Shadowpasha/Flight_Controller_Oqab/docs/oqab_control_estimation_architecture.pdf

## Oqab ESP32 Flight Controller

State Estimation, Multi-Rate Sensor Fusion, and Cascaded Control Architecture

Generated from balance_controller Firmware

November 2026

Abstract

This document describes the complete state estimation and flight control architecture implemented in the Oqab ESP32 quadrotor firmware (balance_controller). It details the dual-core FreeRTOS task split, sensor hardware and coordinate conventions, complementary and Kalman state estimators, optical flow derotation and latency compensation pipeline, autonomous flight mission state machine, PX4-style cascaded position and altitude outer loops, nine selectable inner attitude controllers, and the Quad-X motor mixer. TikZ flowcharts illustrate task execution, sensor fusion dataflows, state transitions, and cascaded feedback loops.

## Contents

1 System Overview and Dual-Core Execution | 2
2 Hardware Sensors and Coordinate Conventions | 2
3 State Estimation Architecture | 3
4 Autonomous Flight Mission State Machine and Safety Guards | 6
5 Cascaded Control Architecture | 6
6 Inner Attitude Controllers (250 Hz) and Flight Modes | 7
7 Quad-X Motor Mixing and Saturation | 9

## 1 System Overview and Dual-Core Execution

The Oqab flight controller runs on an ESP32 dual-core microcontroller using FreeRTOS to isolate deterministic real-time control from asynchronous UART parsing, telemetry serialization, and Flash NVS parameter storage.

- Core 1 (loop(), Priority 15): Executes the deterministic flight control pipeline at 250 Hz (∆t = 4000 µs), with nested time-triggered sub-loops at 50 Hz (20 ms) for vertical/horizontal estimation and outer control loops, and 10 Hz (100 ms) for optional GPS updates.
- Core 0 (CommsTask, Priority 2, 8 KB stack): Runs at 100 Hz (10 ms period via vTaskDelayUntil) on the same core as Bluetooth SPP. It drains Serial2 (MSPv2 optical flow and LiDAR, or NMEA GPS), processes CLI commands over USB Serial (115200 baud) and Bluetooth (Oqab_Flight_Controller), saves tuned parameters to ESP32 NVS Flash (drone_params), and emits telemetry at 20 Hz when disarmed or 50 Hz in simulation mode (muted when armed to prevent serial blocking).

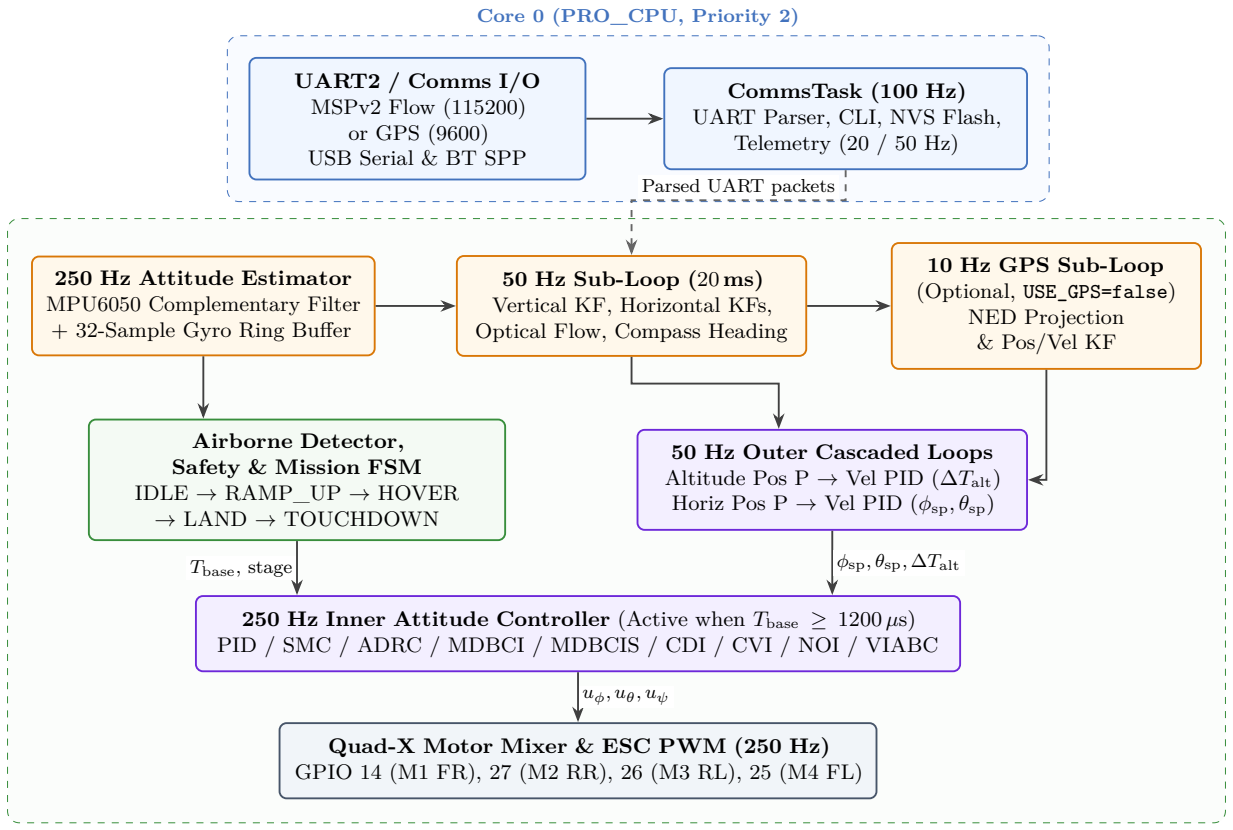
[picture p1: figure]
Core 0 (PRO_CPU, Priority 2); UART2 / Comms I/O MSPv2 Flow (115200) or GPS (9600) USB Serial & BT SPP; CommsTask (100 Hz) UART Parser, CLI, NVS Flash, Telemetry (20 / 50 Hz); 250 Hz Attitude Estimator MPU6050 Complementary Filter + 32-Sample Gyro Ring Buffer; 50 Hz Sub-Loop (20 ms) Vertical KF, Horizontal KFs, Optical Flow, Compass Heading; 10 Hz GPS Sub-Loop (Optional, USE_GPS=false) NED Projection & Pos/Vel KF; Airborne Detector, Safety & Mission FSM IDLE → RAMP_UP → HOVER → LAND → TOUCHDOWN; 50 Hz Outer Cascaded Loops Altitude Pos P → Vel PID (∆Talt) Horiz Pos P → Vel PID (ϕsp, θsp)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

Core 1 (APP_CPU, Priority 15, Deterministic 250 Hz)

250 Hz Inner Attitude Controller (Active when Tbase ≥ 1200 µs) PID / SMC / ADRC / MDBCI / MDBCIS / CDI / CVI / NOI / VIABC

GPIO 14 (M1 FR), 27 (M2 RR), 26 (M3 RL), 25 (M4 FL)

Figure 1: Dual-core FreeRTOS scheduling and multi-rate execution flow across Core 0 and Core 1.

## 2 Hardware Sensors and Coordinate Conventions

### 2.1 Sensor Suite and Interfaces

All sensors sit behind abstract C++ interfaces defined in Sensors.h: IMUInterface, RangefinderInterface, BarometerInterface, CompassInterface, OpticalFlowInterface, and GPSInterface. Table 1 summarizes the hardware drivers and buses.

Subsystem | Hardware / Driver | Bus / Rate | Role in Firmware
IMU | MPU6050 (0x68) | I2C 400 kHz, 250 Hz read | 3-axis | accel | (±8g),
gyro (±500◦/s), 44 Hz
| | | DLPF
Optical Flow & ToF | Mateksys 3901-L0X | UART2 (RX 16, TX 17),
| | 115200 baud

MSPv2 0x1F02 flow,
0x1F01 VL53 ToF Li-DAR (0.03–2.00 m)
Compass | GY-87 (QMC5883P / HMC5883L) | I2C bypass, 50 Hz read | Tilt-compensated True
North yaw reference
GPS (Legacy) | NEO-M8N (NMEA) | UART2 shared,
| | 9600 baud, 10 Hz

Disabled by default
(USE_GPS = false)
Baro / Sharp IR | BMP180 / GP2Y0A | Dewired / Inactive | Bypassed when ToF Li-
DAR mode is enabled
(USE_LIDAR_ONLY_ALTITUDE)

Table 1: Active sensor hardware and bus configuration defined in Config.h and Sensors.cpp.

### 2.2 Body Frame Sign Conventions and Lever Arms

The firmware uses a body-fixed frame where +X points Forward, +Y points Right, and +Z points Down for physical lever-arm offsets relative to the center of mass (CM):

rflow =

−0.04
+0.01
+0.03

m, rimu =

−0.02
+0.02
0.00

m. (1)

From StateEstimator.cpp, gyroscope rates after calibration bias subtraction and axis sign mapping satisfy:

gx = −(gx,raw − bgx)

180
π
(right wing down > 0), | (2)

gy = (gy,raw − bgy)

180
π
(nose down > 0), | (3)

gz = (gz,raw − bgz)

180
π
(clockwise yaw > 0). | (4)

Correspondingly, positive roll ϕ > 0 tilts the right wing down, positive pitch θ > 0 pitches the nose down (accelerating forward), and positive yaw ψ > 0 rotates clockwise when viewed from above.

## 3 State Estimation Architecture

State estimation is partitioned into three estimators: a 250 Hz attitude complementary filter, a 50 Hz 3-state vertical Kalman filter, and two decoupled 50 Hz 3-state horizontal Kalman filters fused with latency-compensated optical flow (and optional 10 Hz GPS). Figure 2 summarizes the full estimation pipeline.

### 3.1 Attitude Complementary Filter (250 Hz)

At each 4 ms step, calibrated accelerometer angles are computed as:

ϕacc = atan2
ay,

q
a

2
x + a

2
z

180
π

, θacc = atan2
ax,

q
a

2
y + a

2
z

180
π
. | (5)

Roll and pitch fuse gyro integration with accelerometer tilt (αatt = 0.991):

ϕk = αatt (ϕk−1 + gx∆t) + (1 − αatt) (ϕacc − ϕcal), | (6)
θk = αatt (θk−1 + gy∆t) + (1 − αatt) (θacc − θcal). | (7)

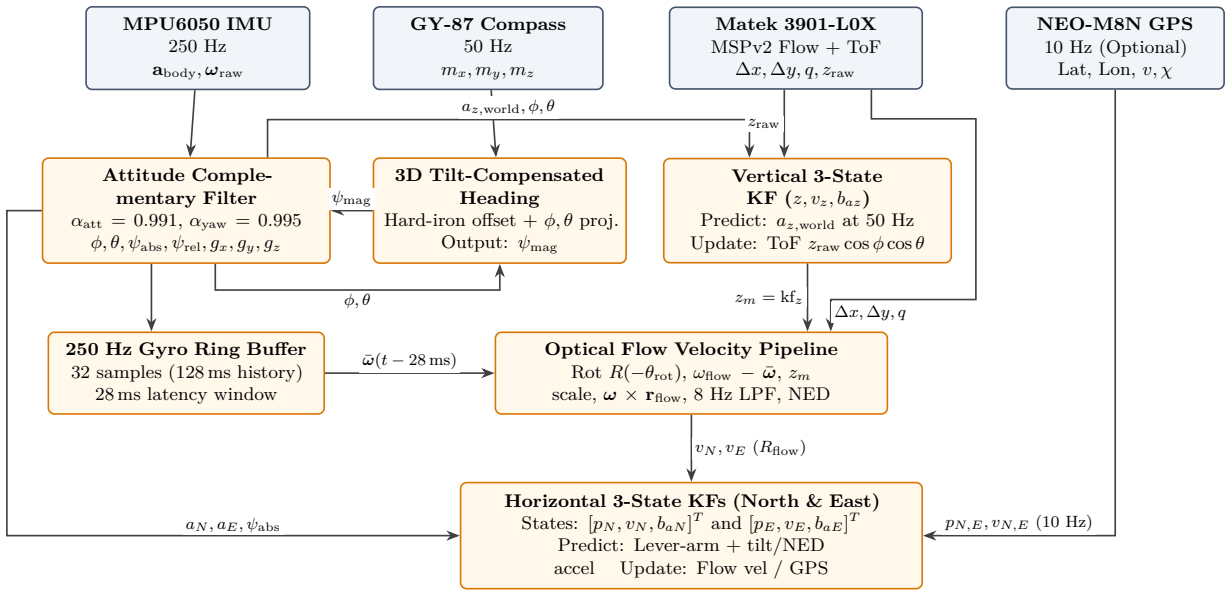
[picture p2: figure]
MPU6050 IMU 250 Hz; abody, ωraw; GY-87 Compass 50 Hz mx, my, mz; Matek 3901-L0X MSPv2 Flow + ToF ∆x, ∆y, q, zraw; NEO-M8N GPS 10 Hz (Optional) Lat, Lon, v, χ; Attitude Comple- mentary Filter αatt = 0.991, αyaw = 0.995 ϕ, θ, ψabs, ψrel, gx, gy, gz; 3D Tilt-Compensated Heading Hard-iron offset + ϕ, θ proj. Output: ψmag; Vertical 3-State KF (z, vz, baz) Predict: az,world at 50 Hz Update: ToF zraw cos ϕ cos θ; 250 Hz Gyro Ring Buffer 32 samples (128 ms history) 28 ms latency window; Optical Flow Velocity Pipeline Rot R(−θrot), ωflow − ω¯, zm scale, ω × rflow, 8 Hz LPF, NED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

Figure 2: Multi-rate sensor fusion and state estimation dataflow across attitude, vertical, and horizontal estimators.

Compass readings (updated at 50 Hz) subtract hard-iron biases (mx0, my0, mz0) and project onto the horizontal plane using (ϕ + ϕcal, θ + θcal):

Xh = mx cos θ + my sin ϕ sin θ + mz cos ϕ sin θ, | Yh = my cos ϕ − mz sin ϕ, | (8)

ψmag = atan2(Yh, Xh)

180
π
+ δmag. | | (9)

Absolute heading fuses gyro gz with ψmag (αyaw = 0.995), wrapped to [−180◦

| , 180◦
]:
ψabs,k = ψabs,k−1 +gz∆t+ (1−αyaw) wrap180(ψmag −ψabs,k−1), | ψrel = wrap180(ψabs −ψoffset). (10)

Crucially, NED world-frame projections for horizontal estimation and position control use ψabs, whereas yaw damping uses body rate gz.

3.2 3-State Vertical Kalman Filter (50 Hz)

The vertical estimator tracks xz = [z, vz, baz]

T
(altitude in m, climb rate in m/s, and vertical accelerometer bias in m/s²
). World vertical acceleration removes gravity along the tilted body axes:
az,world = ax sin θ − ay sin ϕ cos θ + az cos ϕ cos θ − 9.80665. | (11)

When airborne (or in simulation mode), the prediction step propagates with acorr = az,world − baz and state transition matrix Fz:

xz,k|k−1 =

1 ∆t −

1
2∆t

2
0 | 1 | −∆t
0 | 0 | 1

xz,k−1 +

1
2∆t

2
∆t
0

az,world, Qz = diag(0.0002, 0.0035, 0.00003). (12)

Prior to airborne liftoff confirmation, z tracks the ground baseline or valid ToF reading directly with vz = baz = 0 and primed covariance Pz = diag(0.01, 0.05, 0.01). The Mateksys VL53 ToF LiDAR measurement is tilt-compensated:
zrf = zraw cos ϕ cos θ, | (13)

and accepted when LiDAR quality > 30, |ϕ|, |θ| ≤ 35◦
, and 0.03 ≤ zrf ≤ 2.00 m. Scalar Kalman updates use measurement matrix H = [1 0 0] and variance Rlidar = 0.0025 m²

, clamping |baz| ≤ 2.0 m/s² .

### 3.3 Horizontal 3-State Kalman Filters and Optical Flow Pipeline (50 Hz)

Two identical 1D 3-state Kalman filters (kfNorth, kfEast) estimate xh = [p, v, ba]

T along Earth North
and East using Qh = diag(0.005, 0.035, 0.0005).

Inertial Prediction Step

First, IMU centrifugal acceleration from yaw rate gz (in rad/s) due to CM offset (rimu,x, rimu,y) is compensated, gravity projections are canceled, and calibrated static offsets are subtracted:

ax,cm = ax + g

2
z
rimu,x, | ay,cm = ay + g
| 2 z
| rimu,y, | (14)
afwd = ax,cm cos θ − az sin θ − afwd,0, | aright = ay,cm cos ϕ − az sin ϕ − aright,0. | (15)

Rotating into Earth NED via ψabs gives aN = afwd cos ψabs − aright sin ψabs and aE = afwd sin ψabs + aright cos ψabs. Inside predict(), bias-corrected acceleration acorr = ameas − ba applies a noise-floor deadband (|acorr| < 0.015 m/s² ⇒ 0) and velocity clamp |v| ≤ 6.0 m/s. While resting on the ground, states are held at zero to prevent stationary drift.

Optical Flow Velocity Measurement Update

When a new MSPv2 0x1F02 packet arrives with surface tracking quality q ≥ 35, the optical flow estimator (updateOpticalFlowEstimator()) executes six stages:

1. Latency-Matched Gyro Window: Extracts delayed gyro averages (g¯x, g¯y, g¯z) from the 250 Hz 32-sample ring buffer shifted back by round(FLOW_DELAY_MS/4 ms) = 7 samples (28 ms) across the flow integration window (≈ 5 samples for 20 ms).
2. Mounting Rotation & Scaling: Rotates raw counts (sx, sy) by −θrot (default 90◦
) into body
Forward/Right counts and scales by srad = 0.00380 rad/count:

ωflow,x =

sx cos θrot − sy sin θrot
∆t
srad, | ωflow,y =

sx sin θrot + sy cos θrot
∆t
srad. | (16)
3. Gyro Derotation & Height Scaling: Subtracts body angular rates (matching sign conventions: nose-down g¯y and forward translation sweep ground features identically) and scales by clamped vertical KF height zm ∈ [0.05, 3.00] m:
vsens,fwd = (ωflow,x − g¯y)zm, | vsens,right = (ωflow,y − g¯x)zm. | (17)
4. Rigid-Body Lever-Arm Compensation: Removes tangential velocity ω × rflow caused by rotation about the CM (with nose-up rate qup = −g¯y):
vraw,fwd = vsens,fwd − (quprz − g¯zry), | vraw,right = vsens,right − (¯gzrx − g¯xrz), | (18)

clamped to ±3.5 m/s.

5. Low-Pass Filter & NED Rotation: Filters body velocities with a 1st-order exponential LPF (α = 1 − e

−2πfc∆t
, fc = 8.0 Hz) and rotates by ψabs to (vN , vE).
6. Quality-Adaptive Kalman Update: Updates kfNorth.updateVel and kfEast.updateVel when airborne or in sim mode using quality-scaled variance:

Rflow = clamp

2Rflow,0
q/255

, 0.015, 0.40
, Rflow,0 = 0.02 m²
/s
| 2
| . | (19)

When GPS is enabled (updatePositionEstimator() at 10 Hz with ≥ 5 satellites and HDOP ≤ 4.0), flat-Earth lat/lon offsets update position with Rpos = clamp(0.4 HDOP²
, 0.4, 15.0) and Doppler velocity updates velocity with Rvel = 0.08.

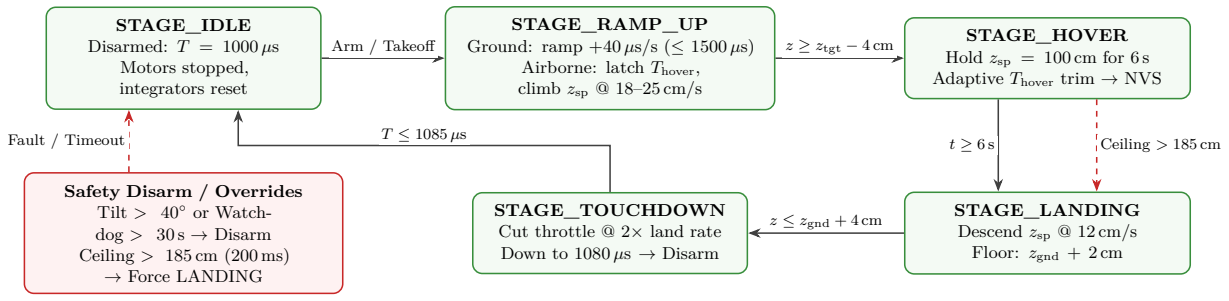
[picture p3: figure]
STAGE_IDLE Disarmed: T = 1000 µs Motors stopped, integrators reset; STAGE_RAMP_UP Ground: ramp +40 µs/s (≤ 1500 µs) Airborne: latch Thover, climb zsp @ 18–25 cm/s; STAGE_HOVER Hold zsp = 100 cm for 6 s Adaptive Thover trim → NVS; Safety Disarm / Overrides Tilt > 40◦ or Watch-; dog > 30 s → Disarm Ceiling > 185 cm (200 ms) → Force LANDING; STAGE_TOUCHDOWN Cut throttle @ 2× land rate Down to 1080 µs → Disarm; STAGE_LANDING Descend zsp @ 12 cm/s Floor: zgnd + 2 cm; Arm / Takeoff; z ≥ ztgt − 4 cm; z ≤ zgnd + 4 cm

T ≤ 1085 µs Fault / Timeout | Ceiling > 185 cm

Figure 3: Autonomous flight mission state machine, airborne liftoff handoff, and safety overrides.

## 4 Autonomous Flight Mission State Machine and Safety Guards

Before the inner attitude loop computes motor commands, Core 1 evaluates airborne detection, safety overrides, and the 5-stage autonomous mission state machine (balance_controller.ino).
Key operational rules in the mission manager:
- Debounced Airborne Confirmation: While armed with Tbase ≥ 1260 µs, liftoff is declared if fused height exceeds zgnd + 5 cm or valid LiDAR exceeds zgnd + 4 cm continuously for 150 ms (fallback: Tbase ≥ 1360 µs sustained for 600 ms). Upon confirmation, open-loop ramping stops and Thover latches within [1280, 1420] µs.
- In-Flight Hover Thrust Learning: During STAGE_HOVER, whenever |z − ztgt| < 5 cm and |vz| < 0.12 m/s, 5% per second of alt_throttle_adj is bled into Thover ∈ [1150, 1550] µs and saved to NVS parameter MPC_THR_HOVER after 2.0 s of steady hover.
- Closed-Loop Activation & Anti-Windup: Attitude controllers stay reset while Tbase < 1200 µs (PID_ACTIVE_THROTTLE). Integral and ESO disturbance terms only accumulate when run_iterm = sim_mode || is_airborne.

## 5 Cascaded Control Architecture

Figure 4 shows the full cascaded control hierarchy connecting the 50 Hz outer position and altitude loops to the 250 Hz inner attitude loop and Quad-X mixer.

250 Hz Inner Control & Mixing

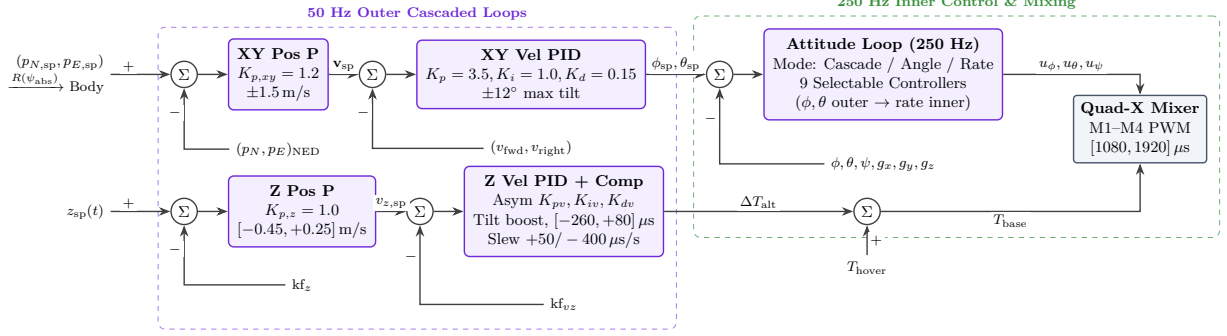
[picture p4: figure]
50 Hz Outer Cascaded Loops; XY Pos P Kp,xy = 1.2 ±1.5 m/s; XY Vel PID Kp = 3.5, Ki = 1.0, Kd = 0.15 ±12◦ max tilt; Z Pos P Kp,z = 1.0 [−0.45, +0.25] m/s; Z Vel PID + Comp Asym Kpv, Kiv, Kdv Tilt boost, [−260, +80] µs Slew +50/ − 400 µs/s; Attitude Loop (250 Hz) Mode: Cascade / Angle / Rate 9 Selectable Controllers; outer → rate inner); Quad-X Mixer M1–M4 PWM [1080, 1920] µs; (pN,sp, pE,sp) R(ψabs) −−−−−−→ Body; zsp(t); vsp; ϕsp, θsp; ∆Talt; Thover; Tbase; (pN , pE)NED; (vfwd, vright); kfz; kfvz

Figure 4: End-to-end cascaded flight control architecture from position/altitude outer loops to Quad-X motor mixing.

### 5.1 Outer Horizontal Position Cascade (50 Hz)

Implemented in computePositionControl() when position hold is active and either Optical Flow or a GPS home lock is available:

1. Setpoint Latch & NED-to-Body Rotation: Upon activation, the current NED position (pN , pE) is latched as (pN,sp, pE,sp). Position errors and filtered NED velocities are rotated into body Forward/Right coordinates via ψabs:
"
efwd

eright#
=

"
cos ψabs | sin ψabs
− sin ψabs | cos ψabs# "pN,sp − pN

pE,sp − pE

. | (20)
2. Outer Position P Loop: Desired body velocities are vsp = clamp(Kp,xye, −vmax, vmax) with Kp,xy = 1.2 s

−1 and vmax = 1.5 m/s.

3. Inner Velocity PID Loop: Velocity errors ev = vsp − v drive desired tilt angles (positive pitch nose-down accelerates forward; positive roll right-wing-down accelerates right):
θsp = clamp(Kp,vev,fwd + Ifwd − Kd,vv˙fwd, −θmax, θmax), | (21)

with Kp,v = 3.5

◦/(m/s), Ki,v = 1.0

◦/m (clamped at ±7.0

◦
), Kd,v = 0.15 (derivative clamped ±3.0

◦
), and θmax = 12.0

◦
. An identical law computes ϕsp on the Right axis.

### 5.2 Outer Vertical Altitude Cascade (50 Hz)

Implemented in computeAltitudeControl():

1. Outer Z Position P Loop: vz,sp = clamp(Kp,z(zsp − z), −vdesc,max, vclimb,max) with Kp,z = 1.0 s

−1
, vclimb,max = 0.25 m/s, and vdesc,max = 0.45 m/s.
2. Inner Z Velocity PID with Asymmetric Gains: Using evz = vz,sp − vz:

az,sp = Kp,eff evz + Ivz − Kd,vz

vz,k − vz,k−1
∆t
, | (22)

Kp,eff =

(
Kp,vz = 1.8 evz ≥ 0 (climb),
2Kp,vz = 3.6 evz < 0 (brake/descend).

(23)

The integrator (Ki,vz = 0.50, clamped [−2.5, 1.2]) freezes positive accumulation and decays at 2.0/s whenever the drone is above target (ez < −0.04 m).

3. Throttle Mapping, Tilt Compensation, and Asymmetric Slew Limit: Acceleration maps to PWM via ∆Traw = az,sp ·

Tbase−1000

9.80665 , plus tilt-thrust boost
1
cos ϕ cos θ − 1
(Tbase−1000) (clamped
+60 µs and attenuated above target). Authority is clamped asymmetrically to [−260, +80] µs (with extra emergency cut above ztgt + 25 cm or 180 cm), then slew-limited to +50 µs/s upward and −400 µs/s downward (−600 µs/s in ceiling emergency).

## 6 Inner Attitude Controllers (250 Hz) and Flight Modes

All nine attitude controllers inherit from AttitudeController and support three flight modes (MODE_CASCADE default, MODE_ANGLE, and MODE_RATE), switchable via ctrl <name>. Figure 5 shows the routing across flight modes and controller laws.

### 6.1 PID Controller (CONTROLLER_PID)

In MODE_CASCADE, outer proportional angle loops (Kp,ang = 2.0, clamped ±400◦/s) generate rate targets ωsp for inner rate PID loops (Kp = 0.625, Ki = 2.1, Kd = 0.0088):

u = Kpeω + Iω − Kdg˙filt, | g˙filt,k = ˙gfilt,k−1 + 0.25

gk − gk−1
∆t

− g˙filt,k−1

. | (24)

To suppress steady limit-cycling, Iω decays by 0.96 per cycle when |eθ| < 1.5

- and saturates at ±150.
Yaw uses rate damping uψ = Kp,ψ(ωψ,sp − gz) with Kp,ψ = 2.0.

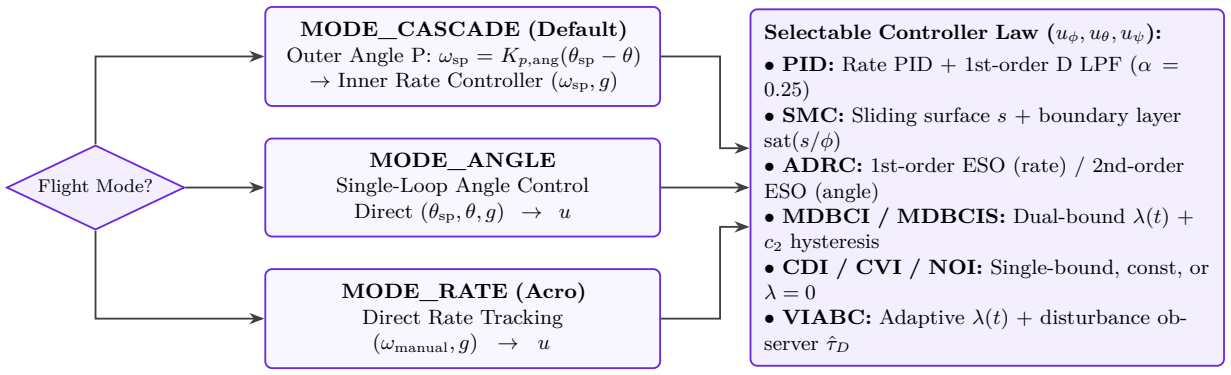
[picture p5: figure]
Flight Mode?; MODE_CASCADE (Default) Outer Angle P: ωsp = Kp,ang(θsp − θ) → Inner Rate Controller (ωsp, g); MODE_ANGLE Single-Loop Angle Control Direct (θsp, θ, g) → u; MODE_RATE (Acro) Direct Rate Tracking; (ωmanual, g) → u; Selectable Controller Law (uϕ, uθ, uψ):; • PID: Rate PID + 1st-order D LPF (α = 0.25); sat(s/ϕ); ESO (angle) • MDBCI / MDBCIS: Dual-bound λ(t) + c2 hysteresis; server τˆD

- SMC: Sliding surface s + boundary layer
- ADRC: 1st-order ESO (rate) / 2nd-order
- CDI / CVI / NOI: Single-bound, const, or
- VIABC: Adaptive λ(t) + disturbance ob-

Figure 5: Flight mode routing and selectable 250 Hz inner attitude controller architectures.

### 6.2 Sliding Mode Controller (CONTROLLER_SMC)

In MODE_CASCADE, an outer P loop (Kp,ang = 1.8, clamped ±220◦/s) feeds an integral sliding surface s = eω + λsmc R
eωdt (λsmc = 2.5, integral clamped ±35 with 0.96 decay inside 1.5

◦
). To eliminate
chattering, the switching term uses a continuous boundary layer (ϕsmc = 20.0):

u = Kp,smc s + Ksw sat

s
ϕsmc

, sat(x) = (
sgn(x) |x| > 1,
x | |x| ≤ 1,

(25)

with defaults Kp,smc = 0.50, Ksw = 28.0 on roll/pitch and Kp,smc = 1.5, Ksw = 20.0 on yaw (no yaw integral).

### 6.3 Linear Active Disturbance Rejection Control (CONTROLLER_ADRC)

ADRC estimates total lumped disturbances (aerodynamic drag, CG imbalance, unmodeled torque) online using an Extended State Observer (ESO) and cancels them directly:

- 1st-Order Discrete LADRC (Cascade Inner Rate & Rate Mode): State z = [ω, ˆ

ˆd]
T
with observer bandwidth ωo = 40 rad/s (l1 = 2ωo, l2 = ω

2
o

), controller bandwidth ωc = 15 rad/s (kp = ωc), and input gain b0 = 1.8 (yaw rate: b0 = 1.0, ωc = 10, ωo = 30):

u =

kp(ωsp − z0) − z1
b0
, | z˙0 = z1 + b0u + l1(ω − z0), | z˙1 = l2(ω − z0). | (26)
- 2nd-Order Discrete LADRC (Angle Mode): State z = [ˆθ, ω, ˆ

ˆd]
T with ωo = 20, ωc = 6, ζ = 1.2, b0 = 1.8 (l1 = 3ωo, l2 = 3ω

2
o

, l3 = ω

3
o

, kp = ω

2
c

, kd = 2ζωc):

u =

kp(θsp − z0) − kdg − z2
b0
, | z˙0 = z1 + l1eobs, | z˙1 = z2 + b0u + l2eobs, | z˙2 = l3eobs. (27)

When run_iterm = false, the disturbance estimate z1 (or z2) is held at zero to avoid ground windup.

### 6.4 Integral Backstepping Family (MDBCI, MDBCIS, CDI, CVI, NOI)

Based on ISA Transactions 2020 (Eq. 44 and Section 4.2), let z1 = q1 − qd be the angle tracking error, χ1 =

R
z1dt ∈ [−20, 20] the integral error, q2 the angular rate, and (qv, qa) the reference rate and acceleration. The Lyapunov backstepping control law is:
τ = −(1 + λ1 + c1c2)z1 − (c1 + c2)(q2 − qv) − c2λ1χ1 + qa, | (28)

with defaults c1 = 1.8 rad/s and c2 = 0.65 s

−1
. The five variants differ solely in how the dynamic integral gain λ1(t) and damping c2 evolve across outer boundary µ = 4.0
- and inner boundary δ = 1.2

◦
(λr = 0.2, λm = 1.5, kλ = 0.25, kr = 0.1):

Variant | Integral Gain Law λ1(t) and Damping Behavior
NOI | No integration: λ1 = 0.
CVI | Conventional integral backstepping: λ1 = λm whenever airborne.
CDI | Conditional integration (Seshagiri & Khalil 2005): λ1 = λm if |z1| ≤ µ, else 0.
MDBCI | Dual-boundary conditional law: λ1 = 0 for |z1| > µ; λ1 = λr for δ < |z1| ≤ µ; for |z1| ≤ δ,
λ˙
1 = kλz1 + kr|qv| (transient) or kλ|z1| + kr|qv| (steady hover), clamped to [0, λm]. MDBCIS Adds hysteresis switching (hz = 0.3

◦
): sets c2 = c2,switch = 0.45 when |z1| ≤ δ and restores c2 = 0.65 when |z1| > δ + hz, mitigating motor jerk and sensor noise.

Table 2: Comparison of the five integral backstepping variants implemented in MDBCI_Axis.

### 6.5 Variable Integral Adaptive Backstepping (VIABC)

Based on IEEE Access 2024, VIABC_Axis updates λ1(t) ∈ [0, 2.5] outside a deadzone ϵ = 0.05◦ via λ˙
1 = Γ1(|z1| + |qv|tss) (Γ0 = 0.2, Γ1 = 0.15) and augments the backstepping torque with a disturbance observer τˆD ∈ [−40, 40] driven by the virtual velocity error z2 = q2 − (−c1z1 − λ1χ1 + qv):

˙τˆD = −Γ2z2 (Γ2 = 0.05), τ = −(1 + λ1 + c1c2)z1 − (c1 + c2)(q2 − qv) − c2λ1χ1 + qa + ˆτD. (29)

## 7 Quad-X Motor Mixing and Saturation

Attitude controller outputs are clamped to |uϕ|, |uθ| ≤ 350 µs (MAX_PID_OUT) and |uψ| ≤ 200 µs (MAX_YAW_OUT), then combined with Tbase in Motors.cpp at 250 Hz:

PWM1 (FR, CCW, GPIO 14)
PWM2 (RR, CW, GPIO 27)
PWM3 (RL, CCW, GPIO 26)
PWM4 (FL, CW, GPIO 25)

=

1 −1 −1 −1
1 −1 +1 +1
1 +1 +1 −1
1 +1 −1 +1

Tbase
uϕ
uθ
uψ

. | (30)

Each ESC channel is constrained to [1080, 1920] µs while armed, or held at 1000 µs when disarmed or running in sim_mode.
