Shadowpasha/Flight_Controller_Oqab/assests/Oqab PNG.png

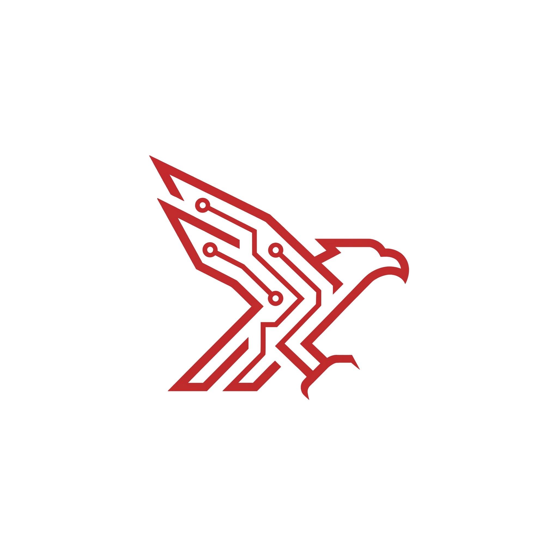
assests/Oqab PNG.png
