Shadowpasha/Flight_Controller_Oqab/hardware/Oqab_FC_2d_view.png

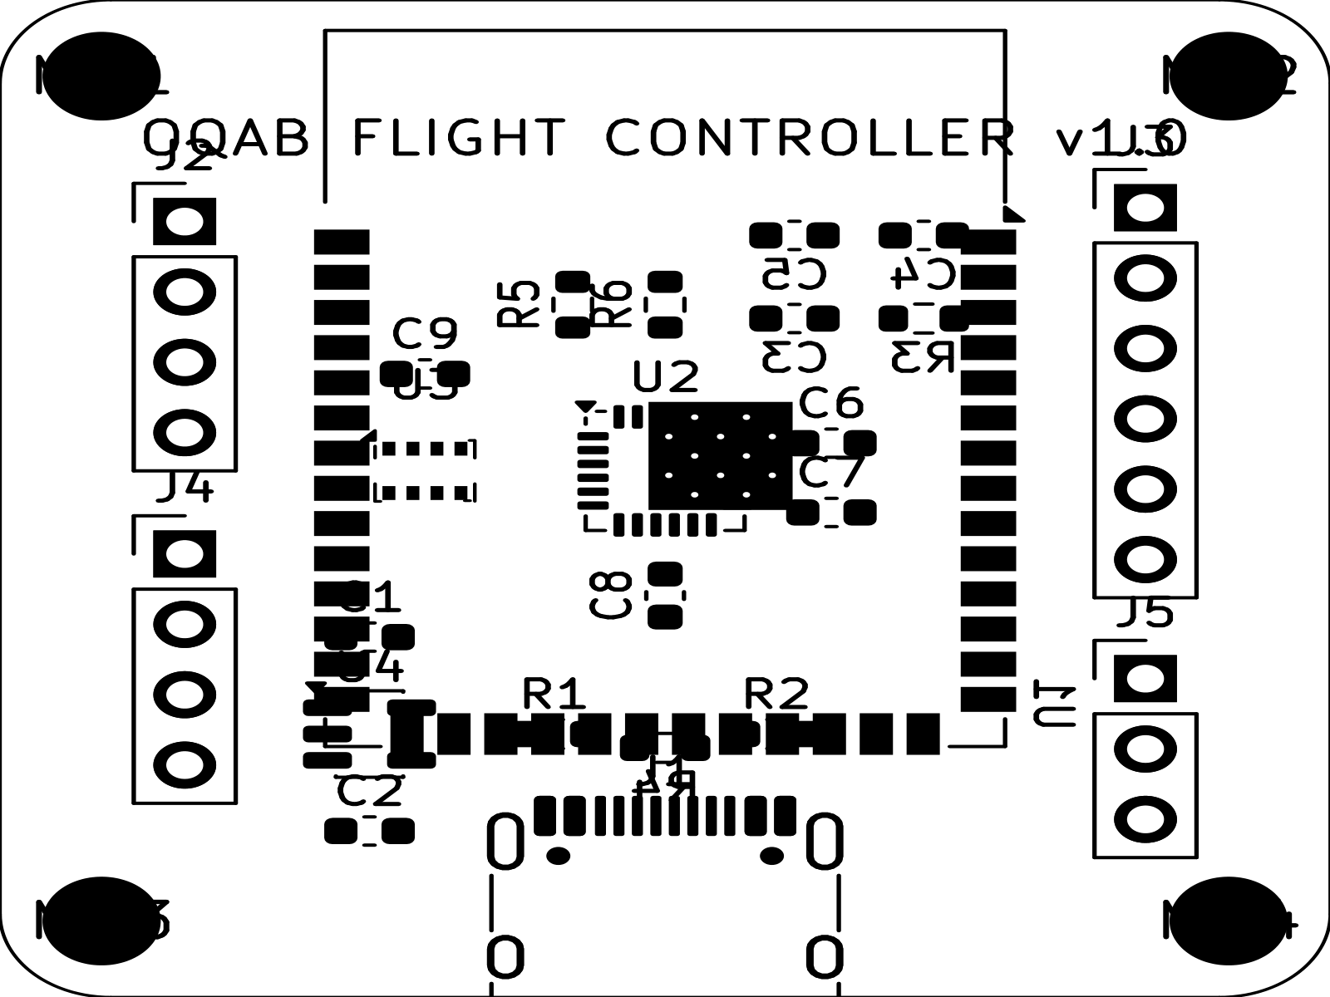
hardware/Oqab_FC_2d_view.png
