Shadowpasha/Flight_Controller_Oqab/(list of files, drawings)

Other design files:
hardware/Oqab_FC.dsn
