Shadowpasha/Flight_Controller_Oqab/hardware/Oqab_FC.kicad_pcb

## KiCad design hardware/Oqab_FC.kicad_pcb (2026-11-11)

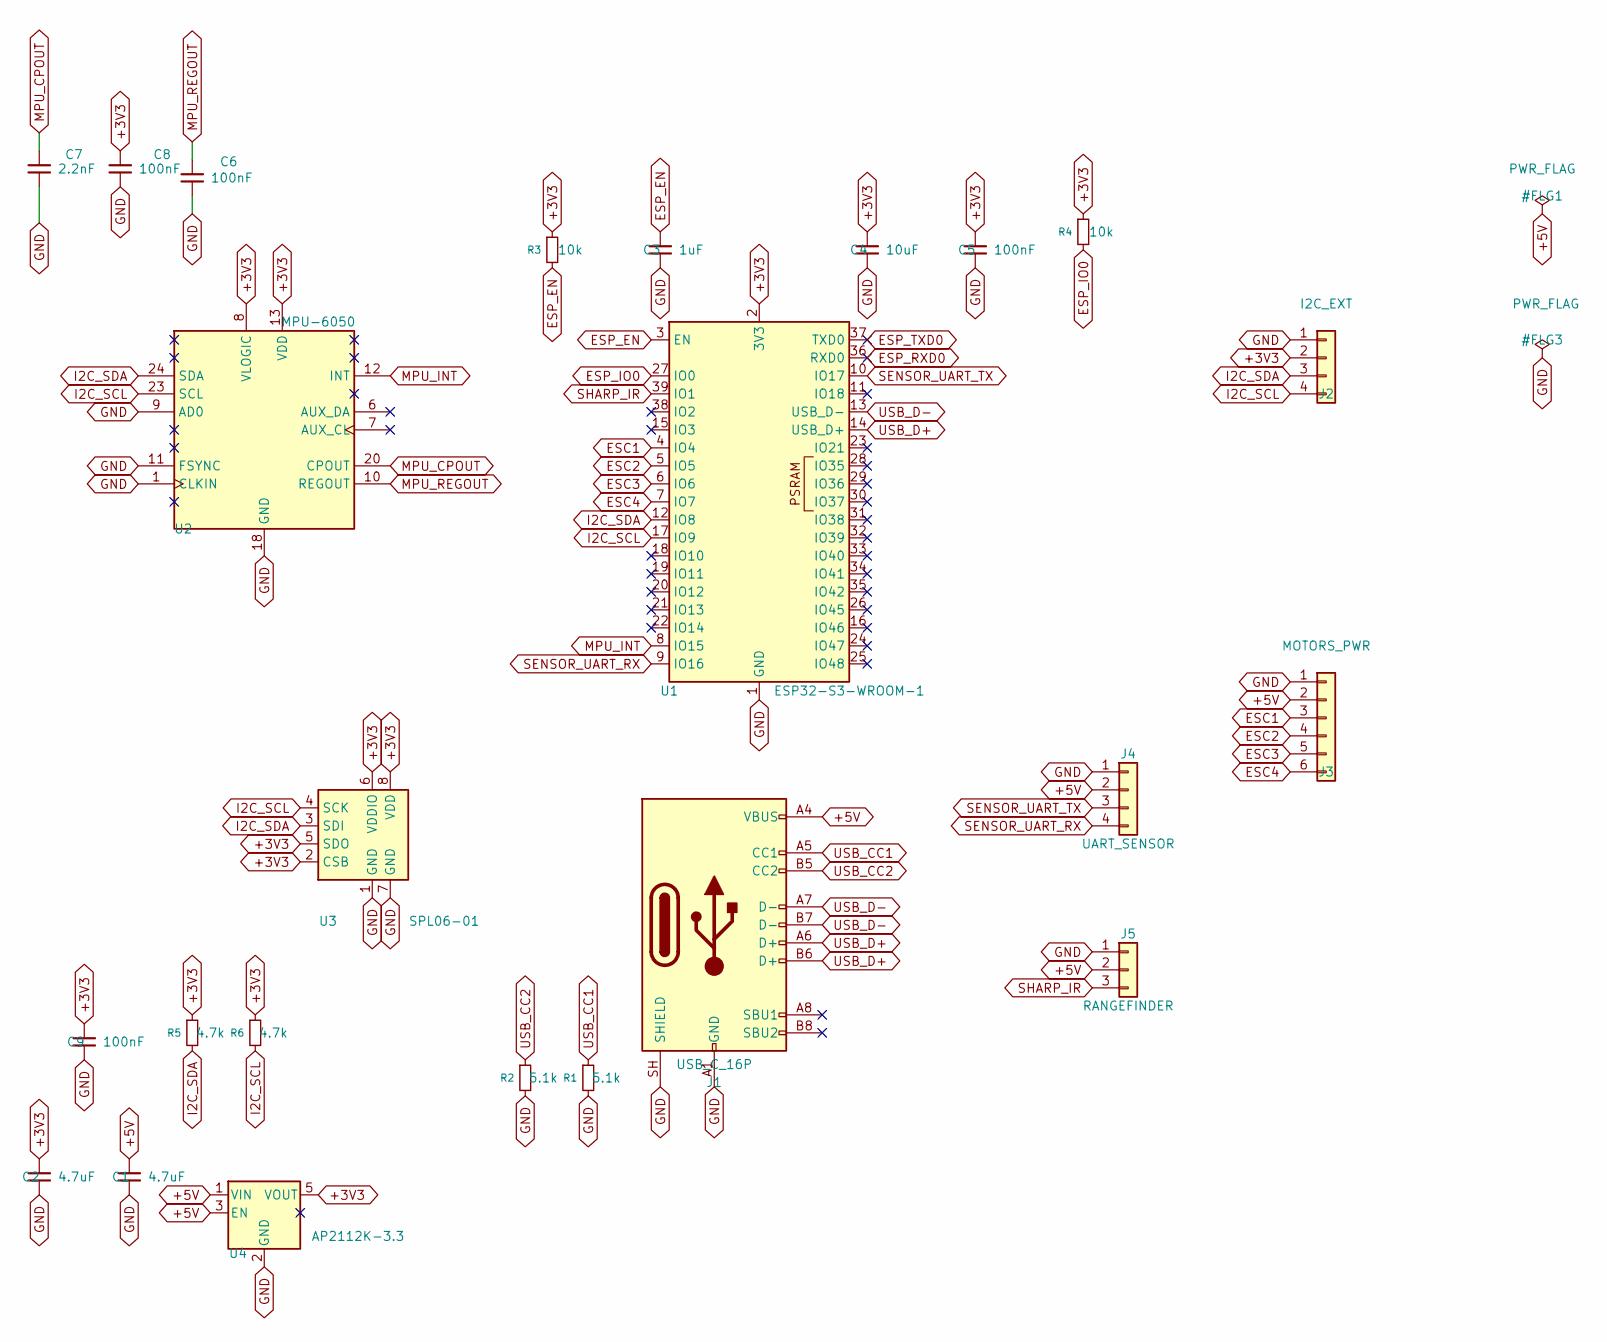
[picture p8: schematic Oqab_FC.kicad_sch]

Parts:
C1, C2: 4.7uF; C_0603_1608Metric
C3: 1uF; C_0603_1608Metric
C4: 10uF; C_0603_1608Metric
C5, C6, C8, C9: 100nF; C_0603_1608Metric
C7: 2.2nF; C_0603_1608Metric
J1: USB_C_16P; USB_C_Receptacle_HRO_TYPE-C-31-M-12
J2: I2C_EXT; PinHeader_1x04_P2.54mm_Vertical
J3: MOTORS_PWR; PinHeader_1x06_P2.54mm_Vertical
J4: UART_SENSOR; PinHeader_1x04_P2.54mm_Vertical
J5: RANGEFINDER; PinHeader_1x03_P2.54mm_Vertical
R1, R2: 5.1k; R_0603_1608Metric
R3, R4: 10k; R_0603_1608Metric
R5, R6: 4.7k; R_0603_1608Metric
U1: ESP32-S3-WROOM-1
U2: MPU-6050; InvenSense_QFN-24_4x4mm_P0.5mm
U3: SPL06-01; Bosch_LGA-8_2x2.5mm_P0.65mm_ClockwisePinNumbering
U4: AP2112K-3.3; SOT-23-5

Connections:
+3V3: C2.1, C4.1, C5.1, C8.1, C9.1, J2.2, R3.1, R4.1, R5.1, R6.1, U1.2 (3V3), U2.8 (VLOGIC), U2.13 (VDD), U3.2 (CSB), U3.5 (SDO), U3.6 (VDDIO), U3.8 (VDD), U4.5 (VOUT)
+5V: C1.1, J1.A4 (VBUS), J1.A9 (VBUS), J1.B4 (VBUS), J1.B9 (VBUS), J3.2, J4.2, J5.2, U4.1 (VIN), U4.3 (EN)
ESC1: J3.3, U1.4 (IO4)
ESC2: J3.4, U1.5 (IO5)
ESC3: J3.5, U1.6 (IO6)
ESC4: J3.6, U1.7 (IO7)
ESP_EN: C3.1, R3.2, U1.3 (EN)
ESP_IO0: R4.2, U1.27 (IO0)
ESP_RXD0: U1.36 (RXD0)
ESP_TXD0: U1.37 (TXD0)
GND: C1.2, C2.2, C3.2, C4.2, C5.2, C6.2, C7.2, C8.2, C9.2, J1.A1 (GND), J1.A12 (GND), J1.B1 (GND), J1.B12 (GND), J1.SH (SHIELD), J2.1, J3.1, J4.1, J5.1, R1.2, R2.2, U1.1 (GND), U1.40 (GND), U1.41 (GND), U2.1 (CLKIN), U2.9 (AD0), U2.11 (FSYNC), U2.18 (GND), U3.1 (GND), U3.7 (GND), U4.2 (GND)
I2C_SCL: J2.4, R6.2, U1.17 (IO9), U2.23 (SCL), U3.4 (SCK)
I2C_SDA: J2.3, R5.2, U1.12 (IO8), U2.24 (SDA), U3.3 (SDI)
MPU_CPOUT: C7.1, U2.20 (CPOUT)
MPU_INT: U1.8 (IO15), U2.12 (INT)
MPU_REGOUT: C6.1, U2.10 (REGOUT)
SENSOR_UART_RX: J4.4, U1.9 (IO16)
SENSOR_UART_TX: J4.3, U1.10 (IO17)
SHARP_IR: J5.3, U1.39 (IO1)
USB_CC1: J1.A5 (CC1), R1.1
USB_CC2: J1.B5 (CC2), R2.1
USB_D+: J1.A6 (D+), J1.B6 (D+), U1.14 (USB_D+)
USB_D-: J1.A7 (D-), J1.B7 (D-), U1.13 (USB_D-)

Board: 2 copper layers, 28 parts (6 on the bottom side), 21 nets, no tracks yet.

Other parts of the board:
MH1, MH2, MH3, MH4: MountingHole_3.2mm
