Shadowpasha/Flight_Controller_Oqab/(commit log)

2026-11-03 feat: integrate Mateksys 3901-L0X optical flow and correct velocity derotation
2026-11-04 Add Tauri ground station dashboard and persist configurable flight parameters to NVS
2026-11-11 Organize firmware into balance_controller, add KiCad hardware files, and update dashboard UI and charts
2026-11-13 Tune F330 position hold, add emergency landing rate & toggleable hover learning
